quaslir/f3scope/(commit log)

2026-10-26 Add CMake build system for STM32F303RE firmware with HAL library, linker script, and OpenOCD flash target.
2026-10-26 Add HAL init and set PA5 LED high in main.cpp
2026-10-27 Add LED blinking demo and enable C++17 support to improve firmware functionality and compile standards.
2026-10-27 Add BSP layer for LED handling and SysTick, refactor main initialization
2026-10-27 Add clock init, error_handler, and run bsp::init only once to simplify the main loop and ensure proper clock configuration.
    [bsp.cpp, bsp.hpp, clock.cpp, main.cpp]
2026-10-27 Add UART driver and board UART configuration constants to enable serial communication.
2026-10-27 Add UART driver, syscalls, sysclk and delay utilities, and update build config
2026-10-27 Decouple UART init from BSP and update clangd configuration.
2026-10-28 Add ADC driver to read analog input values and display in main loop
2026-10-28 Add TIM6 timer driver: init and start at 100kHz
2026-10-28 Add DMA support to ADC driver and configure TIM6 TRGO external trigger
2026-10-28 Add DMA1 interrupt handling and bulk ADC capture API for frame‑ready flag and min/max reporting
2026-10-28 Add DAC driver and enable HAL DAC module, and use it to output a fixed voltage for ADC capture and display min/max results.
    [board.hpp, dac.cpp, main.cpp]
2026-10-29 Make HAL library OBJECT and add 3s delay before UART init
2026-10-29 Add BasicTimer class to replace the global TIM driver and support independent ADC and DAC timers.
    [board.hpp, main.cpp, tim.cpp, tim.hpp]
2026-10-29 Add wave generation support with DMA‑driven DAC and sample capture.
2026-10-29 Add UART framing, checksum, and stop_capture; loop streams continuously.
2026-10-29 Add host scope viewer and raise UART baudrate for higher data rates
2026-10-29 Add trigger‐based window capture using rising edge detection and hysteresis to the firmware, enabling selective data transmission around a trigger point.
2026-10-29 Add interrupt‑driven UART receive with ring buffer and read_byte API
2026-10-30 Add command parser and dynamic settings for sample rate, level, and edge, and expose a runtime timer rate adjustment. New Settings struct and Parser read UART commands to update configuration; main n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
2026-10-30 Fix trigger detection and enable DMA-based UART reception at 1.5 Mbit/s
    [main.cpp, tim.cpp, tim.hpp, uart.cpp]
2026-10-30 Add command and settings support to f3scope host viewer, parsing full “settings:” lines, exposing rate, level, edge and mode, and providing a thread‑safe Commander to send commands from the GUI and t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
2026-10-30 Extract timer calculation to app::timer_math::calculate and update BasicTimer
2026-10-30 Add measurement support for captured frames
2026-10-31 Add OPAMP support: implement driver, board configuration, initialization, and enable HAL OPAMP module.
